HTOWERok/psu_cooler_ficsit/docs/REWORK_v2.md

# Разбор первой печати → план на v2

> **Статус: реализовано в v1.2**, см. `docs/CHANGELOG.md`. Ниже — исходный разбор;
> итоговые массы и время — в changelog и `print/build_report.json`.

Дата: 05.11.2026. Основание: 11 фото из `First_print/`, напечатаны `01_base` и одна `03_wall_rear`.
Снимок исходников на момент разбора: `docs/snapshot_v1.1/`.

---

## 1. Что подтвердилось и уже исправлено (бесплатно, без переделки модели)

**Надпись FICSIT зеркальная — моя ошибка.** В экспорте под печать цоколь и крышка
переворачивались через `mirror([0,0,1])`, а это *отражение*, а не поворот: деталь
получалась зеркальной копией проекта. Винт «причала» при этом остаётся на своём
месте (он симметричен по X), поэтому башня собирается — но логотип читается
наоборот.

Исправлено: `rotate([180,0,0])` вместо `mirror`. Пересобраны `01_base.stl`,
`04_roof.stl` и проекты. Геометрия не менялась — только ориентация в файле.

> **Как правильно переворачивать напечатанную деталь:** вокруг длинной оси (X),
> как она лежала в слайсере. Тогда логотип встаёт на место. Если перевернуть
> вокруг короткой оси — получится зеркало по X, и надпись снова будет наоборот.

---

## 2. Пункты и что с ними делать

| № | Замечание | Причина (моя/процесса) | Решение | Перепечатка |
|---|---|---|---|---|
| 1 | Просадка после «ступеней», похоже на эхо / малый PA | Не модель: на смене направления поток не успевает, + узкие ступени на лицевой грани | PA 0.03 → 0.045; `outer_wall_acceleration` 5000 → 3000; фаски на кромках полос | нет, профиль |
| 2 | Провода кулеров некуда вывести: резал стенку, фрезеровал 2 пропила | Каналы были только по центру кармана (x = ±44), а провод выходит из угла рамки кулера | Кольцевой жёлоб 10 × 4 мм вокруг каждого кармана (скрыт под лотком), соединён с существующими каналами | `01_base` (по желанию) |
| 3, 4, 6 | Ложбинки под провод | — | Нужны размеры (или сделаю по фото) | `01_base` |
| 5 | Логотип не туда | см. п.1 | исправлено | `01_base`, `04_roof` |
| 7а | Недолив первого слоя при потоке 1.2 | Ширина линии 0.65 при сопле 0.6 — линиям некуда раздаться, поток уже на пределе | `initial_layer_line_width` 0.65 → 0.75; слой первого слоя 0.4 → 0.35 | нет, профиль |
| 7б | Два прямоугольника на причале ни о чём | Я делал их пазами под стяжку, но 2 мм глубины ничего не держат, а провод идёт снизу | Убрать; вместо них два сквозных паза 18 × 4 мм под стяжку | `01_base` |
| 8 | Переэкструзия верхнего слоя стенки | Перемычки между сотами 3.3 мм при линии 0.62: остаток 0.2 мм забивается «щелевым» доливом | Перемычка 3.3 → 3.1 мм (=5 × 0.62); `top_surface_flow` 0.95 | `02/03_wall` |
| 9 | «Уши» задирает, комки, отверстия не печатаются | Ухо — башня 28 мм высотой и 4 мм толщиной; отверстие M3 идёт горизонтально и провисает | Полка 4 → 6 мм; скругления R2 и фаска на торце; отверстие «каплей» (teardrop) | `02/03_wall` |

---

## 3. Что именно меняю в модели (v2)

### `02/03_wall`
1. **Полка уха 4 → 6 мм** (z 34…40 вместо 36…40). Кирпичный паз 38…40 не трогаю.
2. **Скругления R2** на внешних углах уха и **фаска 1.5 × 45°** на торце — снимает комки на углах.
3. **Отверстия «каплей»**: Ø3.6 (крепление к цоколю) и Ø4.4 (крышка) получают
   45-градусный свод сверху по направлению печати — горизонтальное отверстие
   перестаёт провисать.
4. **Перемычка сот 3.3 → 3.1 мм**.

### `01_base` (только если печатать заново)
1. Ориентация (п.1) — уже исправлено.
2. **Жёлоб под провода**: кольцо 10 × 4 мм вокруг каждого кармана на нижней плоскости,
   соединённое с каналами x = ±44. Провод выходит из любого угла кулера.
3. **Пазы причала**: два сквозных 18 × 4 мм вместо двух неглубоких прямоугольников.

### `04_roof`
Ориентация исправлена, больше ничего.

### Профили (`DSH_JAMG-HE ABS` / `DSH ABS 0.6 0.2mm`)
- `initial_layer_line_width` 0.75, `initial_layer_print_height` 0.35;
- `pressure_advance` 0.045;
- `outer_wall_acceleration` 3000;
- `top_surface_flow` 0.95.

---

## 4. Что нужно от тебя

1. **Размеры ложбинок** (пункты 3, 4, 6): длина × ширина × глубина и на каком
   расстоянии от края — или «сделай как на фото», тогда возьму 25 × 4 × 4 мм.
2. **Пункт 1**: на каком именно месте просадка — на лицевой грани (полосы/логотип)
   или на полке причала? От этого зависит, править модель или только профиль.
3. **Печатать ли цоколь заново.** Если да — 4 ч 10 м и ~131 г, зато логотип,
   жёлоб и пазы. Если нет — оставляем напечатанный, а правки уходят в v2 для будущих.
