HTOWERok/psu_cooler_ficsit/photos/05_front_with_roof.jpg

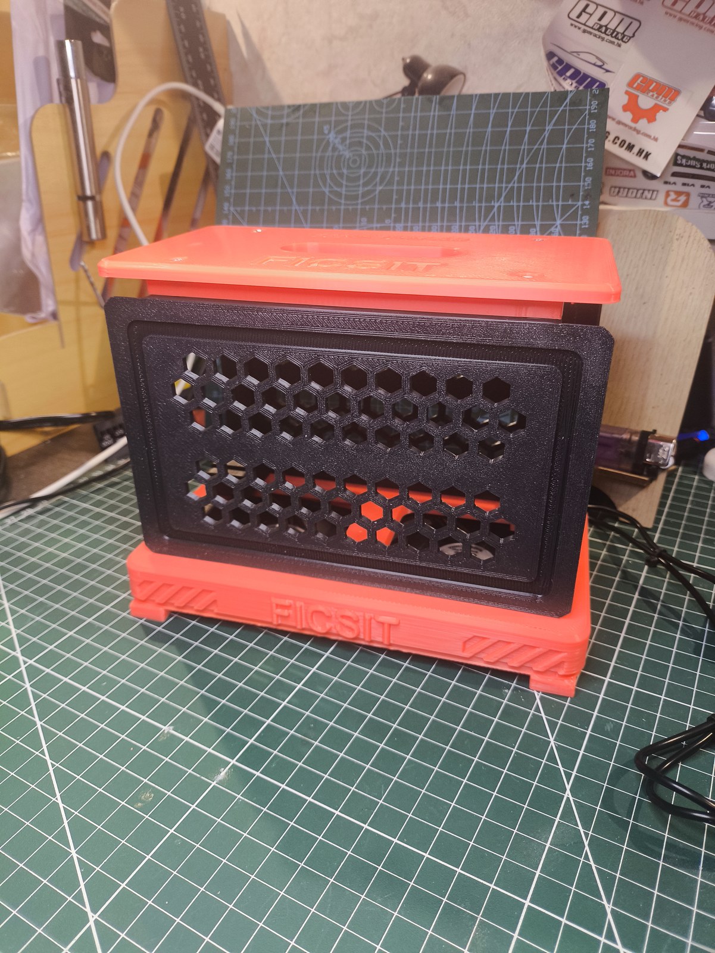
photos/05_front_with_roof.jpg
