HTOWERok/psu_cooler_ficsit/photos/06_base_underside.jpg

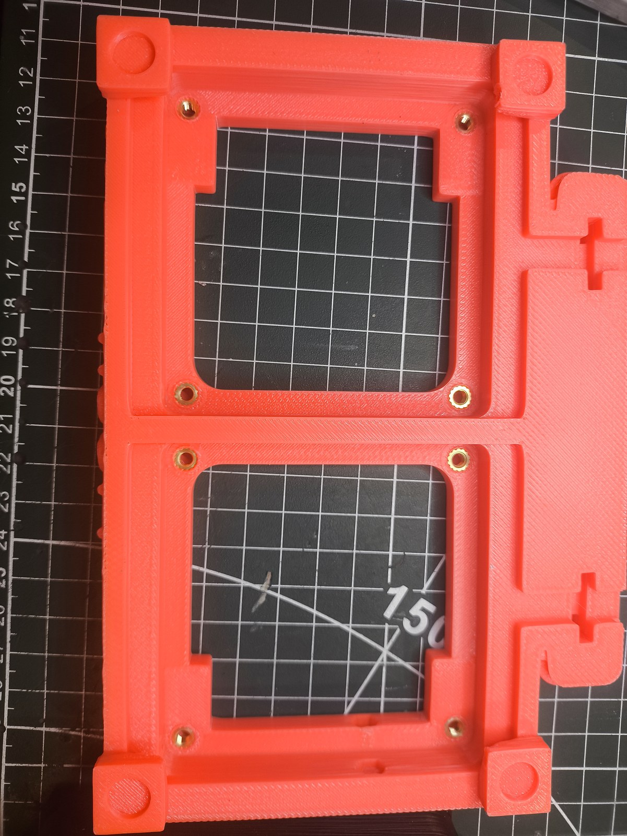
photos/06_base_underside.jpg
