HTOWERok/psu_cooler_ficsit/photos/07_heat_inserts.jpg

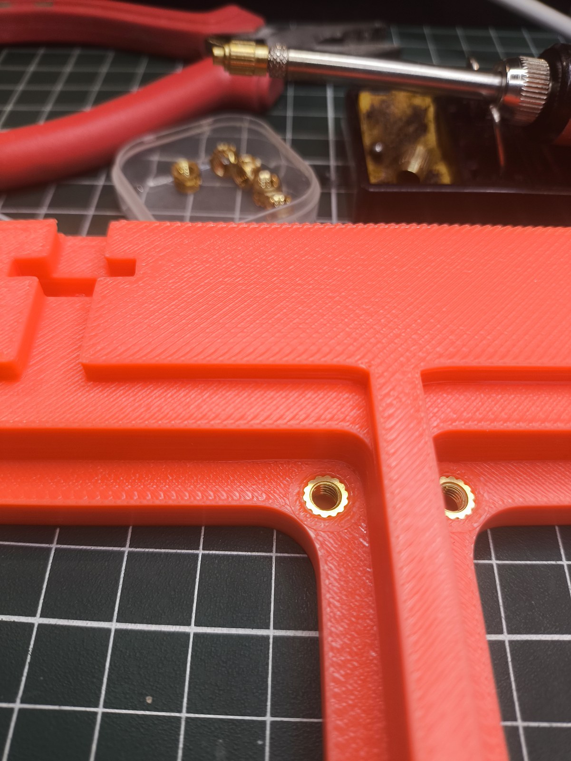
photos/07_heat_inserts.jpg
