HTOWERok/psu_cooler_ficsit/renders/02_open.png

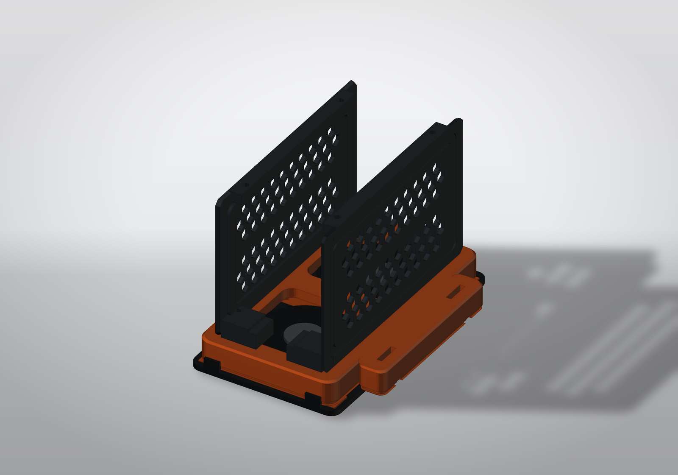
renders/02_open.png
