HTOWERok/psu_cooler_ficsit/renders/04_front.png

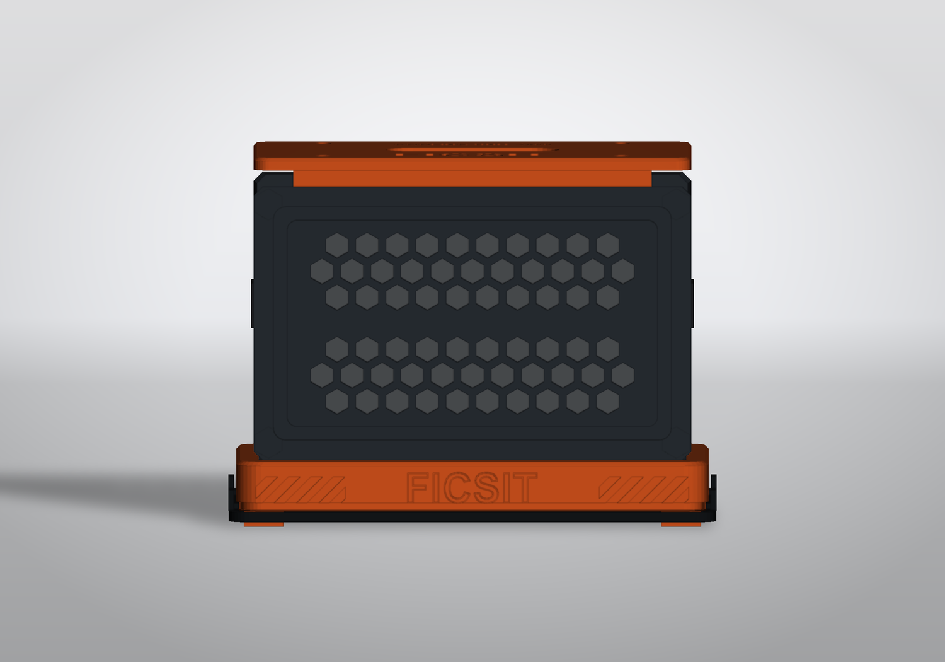
renders/04_front.png
