HTOWERok/psu_cooler_ficsit/renders/05_detail.png

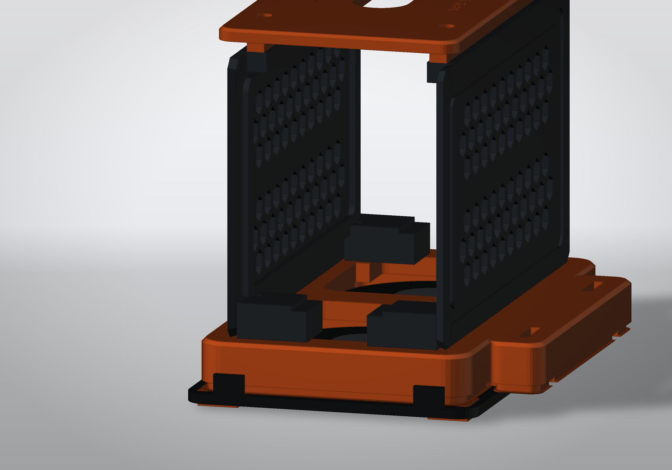
renders/05_detail.png
