HTOWERok/psu_cooler_ficsit/renders/06_top.png

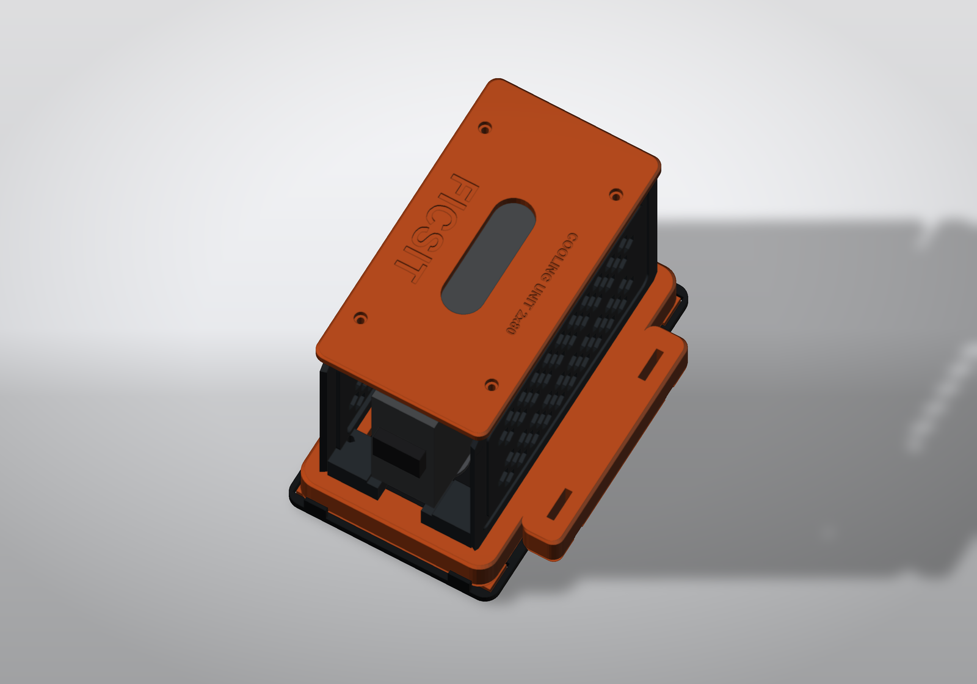
renders/06_top.png
