HTOWERok/psu_cooler_ficsit/renders/section_01_base_z8.png

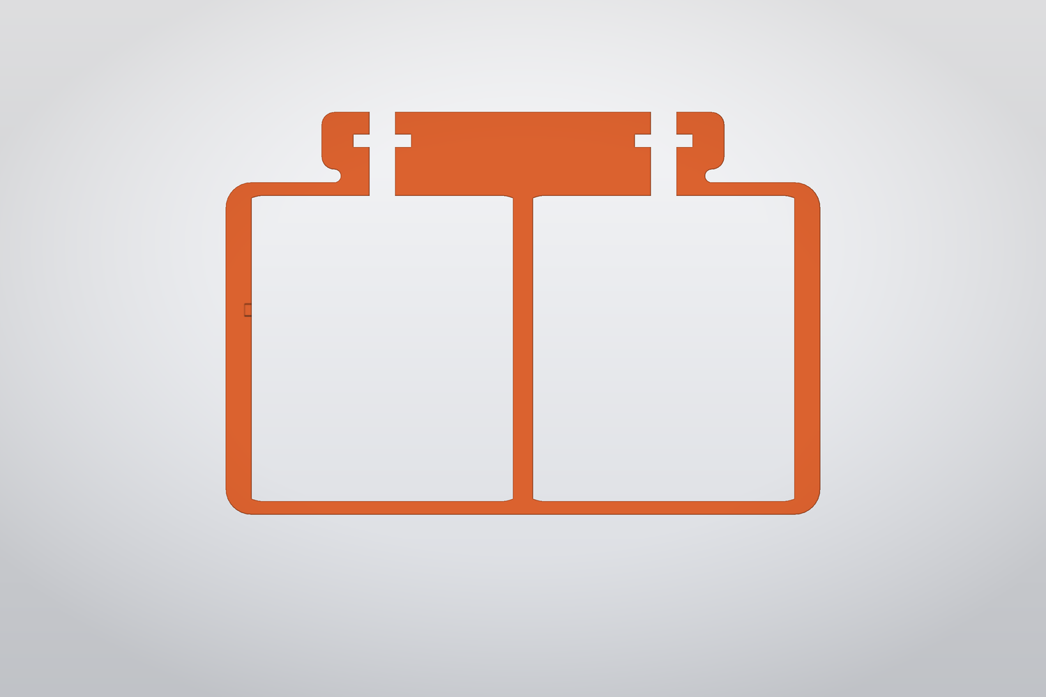
renders/section_01_base_z8.png
