HTOWERok/psu_cooler_ficsit/renders/section_01_base_z22.png

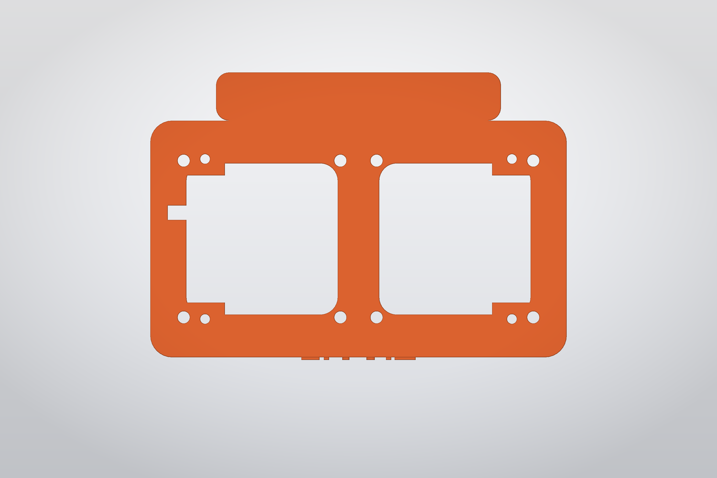
renders/section_01_base_z22.png
