HTOWERok/psu_cooler_ficsit/print/projects/03_wall_rear.3mf

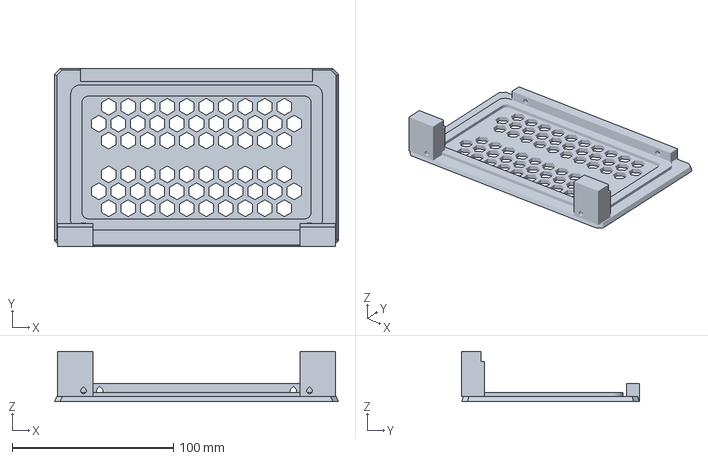
[picture p18: CAD file, 2026-11-09]
print/projects/03_wall_rear.3mf
176.0 x 110.0 x 31.2 mm
