HTOWERok/psu_cooler_ficsit/print/projects/01_base.3mf

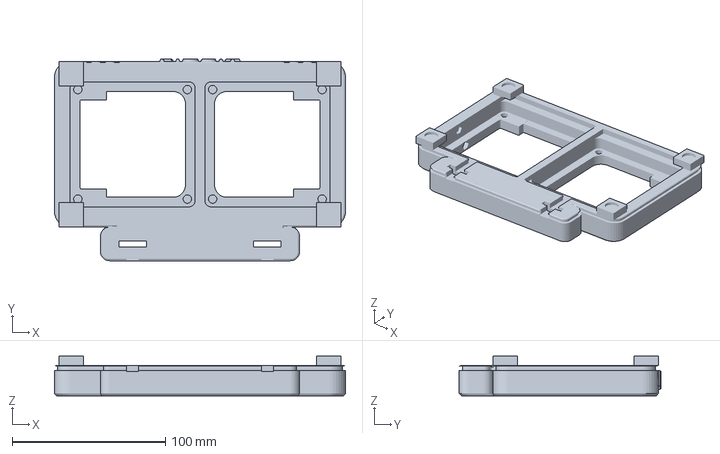
[picture p19: CAD file, 2026-11-09]
print/projects/01_base.3mf
190.0 x 131.6 x 26.0 mm
