HTOWERok/psu_cooler_ficsit/print/projects/05_filter_tray.3mf

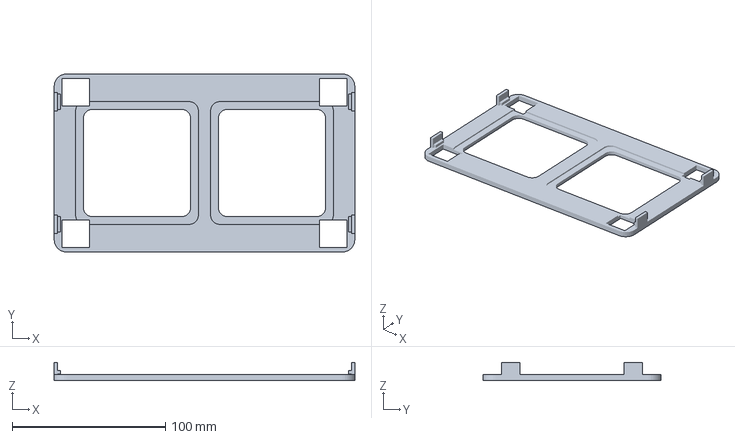
[picture p20: CAD file, 2026-11-09]
print/projects/05_filter_tray.3mf
196.2 x 116.0 x 12.0 mm
