HTOWERok/psu_cooler_ficsit/stl/04_roof.stl

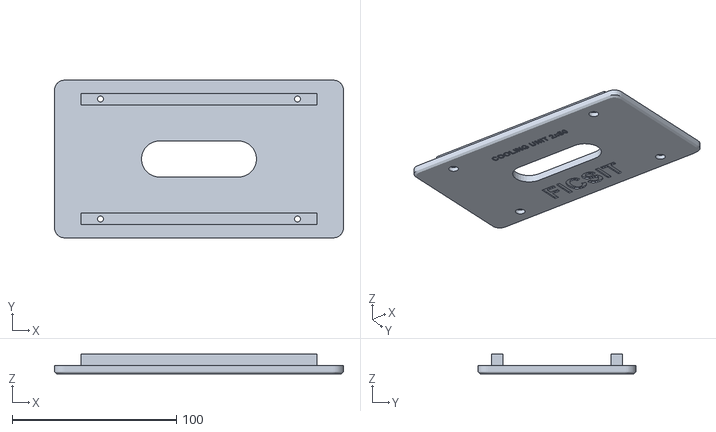
[picture p21: CAD file, 2026-11-09]
stl/04_roof.stl
176.0 x 96.0 x 12.0
