HTOWERok/psu_cooler_ficsit/(list of files, cad)

Other CAD files:
stl/03_wall_rear.stl
stl/02_wall_front.stl
print/projects/04_roof.3mf
stl/01_base.stl
print/projects/02_wall_front.3mf
stl/05_filter_tray.stl
