HTOWERok/psu_cooler_ficsit/print/README.md

# Печать: ABS, сопло 0,6, OrcaSlicer

Всё подготовлено, **печать не запущена**, Z-offset и настройки принтера не тронуты.

- **Профили:** `JAMG-HE ABS` → копия **`DSH_JAMG-HE ABS`** (установлена в орку), процесс → **`DSH ABS 0.6 0.2mm`** (установлен).
- **Проекты:** 5 файлов в `projects/` — открыть двойным щелчком, каждый уже с расставленной деталью, бримом и профилями.
- **Проверено слайсером:** все пять режутся без ошибок, поддержек — **0 грамм**.

---

## 1. Что печатаем и сколько это стоит

| № | Деталь | Слой | Слоёв | Пластик | Время | Поддержки |
|---|---|---|---|---|---|---|
| 1 | `05_filter_tray` | 0,2 | 59 | **37,9 г** | 1 ч 04 м | 0 |
| 2 | `04_roof` | 0,2 | 59 | **61,7 г** | 1 ч 48 м | 0 |
| 3 | `02_wall_front` | 0,2 | 155 | **65,1 г** | 2 ч 23 м | 0 |
| 4 | `03_wall_rear` | 0,2 | 155 | **64,7 г** | 2 ч 22 м | 0 |
| 5 | `01_base` | 0,2 | 129 | **129,6 г** | 4 ч 12 м | 0 |
| | **Итого** | | | **≈ 359 г** | **≈ 11 ч 30 м** | **0** |

Проверьте, что в катушке больше 400 г — на брим, продувку и возможный перезапуск.

> **v1.1 (исправление):** в цоколе отверстие M3 под стойку стенки стояло в 3,26 мм от отверстия M4 под кулер — при радиусах 2,2 + 2,75 они прорезали друг друга, и бонку некуда было вплавить. Стойки M3 перенесены с x = ±77 на x = ±70 (y = 36,5), а в «полке» деки сделаны местные утолщения, чтобы под них появилось мясо. Заодно исправлено отверстие M3 в самой стенке: раньше оно не проходило сквозь полку кронштейна. Пересобраны `stl/01_base.stl`, `stl/02_wall_front.stl`, `stl/03_wall_rear.stl` и три проекта; фильтр-лоток и крышка не менялись.

---

## 2. Порядок печати

1. **`05_filter_tray`** — самый быстрый и самый «показательный»: на нём видно, легла ли линия, держится ли брим, нет ли отрыва углов. Если что-то не так — вы теряете час, а не четыре.
2. **`04_roof`** — вторая проверка, уже с гравировкой на первом слое.
3. **`02_wall_front`**, затем **`03_wall_rear`** — они одинаковые по времени; между ними дайте столу остыть и проверьте, не повело ли первую.
4. **`01_base`** — самая большая и самая капризная по короблению. Печатать последней, когда профиль уже подтверждён.

---

## 3. Что в профиле было не так и что я изменил

Профиль **`JAMG-HE ABS`** рабочий, но собран на скелете PLA: `inherits: Flashforge Generic PLA`, и в нём несколько мест, которые для ABS либо инертны, либо вредны.

### Копия `DSH_JAMG-HE ABS` — отличия от оригинала (4 правки)

| Параметр | Было | Стало | Почему |
|---|---|---|---|
| `during_print_exhaust_fan_speed` | 70 % | **0 %** | Вытяжка во время печати выдувает тёплый воздух из камеры → перепад → отрыв углов. После печати остаётся 70 % (`complete_print_exhaust_fan_speed`), чтобы вытянуть запах. |
| `overhang_fan_speed` | 30 % | **20 %** | Было больше `fan_max_speed` (20 %) — на нависаниях обдув бил сильнее, чем разрешено для ABS. Теперь не превышает потолок. |
| `slow_down_layer_time` | 150 с | **15 с** | При `slow_down_for_layer_cooling = 0` параметр не работает, но если когда-нибудь включить охлаждение — 150 с на слой превратят печать в бесконечность. Приведено к безопасному значению. |
| компенсация усадки | нет | **нет** | Специально не добавлял: зазоры в модели (0,3–1,4 мм) уже перекрывают усадку ABS 0,4–0,6 %. Плюс в CLI-слайсе параметр не применяется, и я не хочу, чтобы «проверено» и «напечатано» расходились. |

Температуры, обдув, ретракт, MVS — **не тронуты**: 255/260 °C, стол 90/100 °C, обдув 10–20 %, MVS 20 мм³/с. Всё в пределах заявленного диапазона сопла 240–280 °C.

### Правки v1.2 (по итогам первой печати)

| Параметр | Было | Стало | Почему |
|---|---|---|---|
| `initial_layer_line_width` | 0,65 | **0,72** | На первом слое просветы между линиями: при сопле 0,6 и потоке 1,2 линии ширины не хватало |
| `initial_layer_print_height` | 0,40 | **0,35** | Больше прижима, не трогая Z-offset |
| `top_surface_flow` | 1,0 | **0,95** | Верхняя поверхность стенки была перелита (узкие перемычки между сотами) |
| `pressure_advance` | 0,03 | **0,045** | Просадка после ступеней на лицевой грани |
| `outer_wall_acceleration` | 5000 | **3000** | Там же: меньше «эха» на смене направления |

### Выходной G-код — включены все четыре опции

| В UI | Ключ | Что даёт |
|---|---|---|
| Откат только при пересечении периметров | `reduce_infill_retraction` = 1 | нет ретракта внутри заполнения |
| Подробный G-код | `gcode_comments` = 1 | к каждой строке — комментарий с типом элемента |
| Помечать модели | `gcode_label_objects` = 1 | `;EXCLUDE_OBJECT_DEFINE/START/END` вокруг детали |
| Исключение объектов | `exclude_object` = 1 | принтер может пропустить объект, не останавливая печать |

Отдельного ключа `verbose_gcode` в Orca 2.3.2 нет (проверено по `OrcaSlicer.dll`) — за «Подробный G-код» отвечает `gcode_comments`.

Файлы от этого выросли: цоколь **33,4 МБ**, стенка **13,3 МБ**, крышка **11,0 МБ**, лоток **4,7 МБ** (до правки было в 3–4 раза меньше). На время печати это не влияет, но загрузка по Wi-Fi и разбор файла принтером станут заметно дольше.

### Что осталось как есть (но знать полезно)

- **`inherits: Flashforge Generic PLA`** — работает, но хрупко: тянет из PLA `filament_flow_ratio 0.98` и прочие мелочи. Копию я оставил на том же родителе, чтобы поведение было предсказуемым. Если захотите «чистый» профиль — перевесить родителя на `Flashforge Generic ABS` и заново проверить поток.
- **`slow_down_layer_time = 150`** в оригинале — см. выше, исправлено в копии.
- **`filament_max_volumetric_speed = 20`** — для ABS на 0,6 это на грани, но скорости процесса (внешняя стенка 150, заполнение 100–150) держат расход ниже. Не менял.
- **`flexible? нет`**, `filament_density 1.04` ✓ — масса в отчёте считается верно.

### Процесс `DSH ABS 0.6 0.2mm` — отличия от вашего `Jamg-HE - ABS 0,18`

| Параметр | Было | Стало | Почему |
|---|---|---|---|
| Поддержки | вкл, tree(auto), 55° | **выкл** | См. раздел 4 — детали спроектированы без нависаний >45°, поддержки дают 0 г. |
| Брим | auto | **outer_only, 8 мм** | ABS + большая плоская деталь: брим по внешнему контуру держит углы, внутрь окон не лезет. |
| Слоновья нога | 0 | **0,15 мм** | Первый слой 0,4 мм на PEI-столе иначе раздаётся на 0,2–0,3 мм, и посадочные места теряют точность. |
| Тип стола | Cool Plate (35 °C!) | **Textured PEI** (100 → 90 °C) | При экспорте проект по умолчанию брал «холодный стол» — ABS бы просто не прилип. |

Остальное — ваши значения: 0,2 мм слой, 0,4 первый, 3 периметра, 30 % gyroid, 4 верхних слоя, arachne, шов сзади.

---

## 4. Поддержки: почему 0 г

Проверял не «на глаз», а слайсером:

- с вашим включённым `tree(auto) 55°` → `;TYPE:Support` в gcode **нет**, масса та же 38,84 г;
- принудительно `support_threshold_angle = 20°` → **тоже 0**.

Причина: все детали печатаются в ориентации, где нависания — только фаски 45° и кромки сот, а порог стоит 55°. Дерево в ABS ещё и приваривается к модели, оставляя следы на видимых гранях. Поэтому поддержки выключены — это не «забыл», это осознанно.

Если всё же захотите: в проекте `Support → Enable` и порог 40–45°, но тогда на кромках сот появятся следы.

---

## 5. Перед стартом — проверьте

- [ ] **Катушка:** ≥ 400 г чёрного ABS.
- [ ] **Стол:** текстурированная PEI-пластина, обезжирена. В проекте стоит `Textured PEI Plate`, 100 °C первый слой → 90 °C дальше.
- [ ] **Сопло 0,6** — в проекте `nozzle_diameter 0.6`, ширина линии 0,62.
- [ ] **Z-offset не трогаем** (как просили). Если первый слой примнёт — правьте только `flow` первого слоя или высоту слоя, не офсет.
- [ ] **Камера:** для 190-мм детали желательно закрыть корпус/поставить щит — сквозняк отрывает углы быстрее, чем что-либо ещё. В орке: `Others → Draft shield` (увеличит время примерно на 20–25 %).
- [ ] **Первый слой** смотрите на `05_filter_tray`: брим 8 мм по контуру должен быть сплошным, без «перьев».

Если углы всё же поднимаются: поднять стол до 100 °C (это всё ещё норма для ABS) и уменьшить обдув до 0 на первых 5–6 слоях (сейчас `close_fan_the_first_x_layers = 3`).

---

## 6. Физический принтер в проектах

Во всех пяти `.3mf` записан принтер `Flashforge Adventurer 5M 0.6 Nozzle - DSH`:

| Поле в Orca | Ключ | Значение |
|---|---|---|
| Сохранить принтер как | `printer_settings_id` | Flashforge Adventurer 5M 0.6 Nozzle - DSH |
| Тип хоста | `host_type` | `flashforge` |
| Имя хоста, IP | `print_host` | `192.168.31.30` |

Сетевой агент (`printer_agent`), сертификат и проверки отзыва Orca в проект не пишет — они остаются дефолтными, и в диалоге это как раз «Orca», пусто и галочка снята. Проверено пробным экспортом: Orca при выбранном DSH-принтере кладёт в 3mf ровно три поля выше.

Значения заданы в `build_projects.py` (словарь `HOST`), так что при пересборке проектов они не потеряются.

Что важно знать:

- процесс `DSH ABS 0.6 0.2mm` объявлен совместимым **с обоими** принтерами (`… Nozzle` и `… - DSH`). Без второго имени Orca при открытии проекта считала процесс несовместимым и откатывала выбор принтера на базовый;
- сам **принтер** — это пользовательский пресет в профиле Orca, а не часть 3mf. Один раз сохраните его с тем же именем (`… - DSH`) — и все пять проектов подхватят его автоматически;
- на другом компьютере/профиле проекта этого пресета не будет, и Orca откроет проект с базовым принтером. Лечится тем же сохранением под тем же именем;
- слайсер в пайплайне режет с **базовым** именем (`Flashforge Adventurer 5M 0.6 Nozzle`) — CLI не умеет работать с пользовательскими пресетами. Поэтому в `build_report.json` цифры сняты с базового пресета, а в готовый проект записано имя с хостом.

---

## 7. Что где лежит

```
print/
├─ projects/                 ← 5 готовых проектов орки (открывать их)
│  ├─ 01_base.3mf            190 × 131,6, «вверх дном», 129 слоёв
│  ├─ 02_wall_front.3mf      наружной гранью вниз
│  ├─ 03_wall_rear.3mf       зеркальная
│  ├─ 04_roof.3mf            верхней плоскостью вниз
│  └─ 05_filter_tray.3mf     плоско, клипсами вверх
├─ presets/                  ← те же профили для «Load preset from file»
├─ gcode_check/plate_1.gcode ← контрольный слайс фильтр-лотка (можно открыть в орке)
├─ build_report.json         ← цифры из слайсера (слои, масса, время, размер gcode)
├─ filament_flat.json        ← ровно тот конфиг, что ушёл в проекты
├─ process_flat.json
├─ machine_flat.json
├─ flatten.py                ← разворачивает цепочку наследования в один файл
├─ build_projects.py         ← экспорт + патч + слайс
├─ test_variants.py          ← A/B: поддержки, усадка
└─ install_presets.py        ← установка профилей в орку
```

### Про имена профилей

Файлы в орке: `filament\DSH_JAMG-HE ABS.json` и `process\DSH ABS 0.6 0.2mm.json`
(плюс `.info`). **Орка была открыта** во время установки — если профили не появились в списке, перезапустите её. Даже без профилей проекты самодостаточны: все настройки лежат внутри `.3mf`.

### Почему проектов пять, а не один

Детали не помещаются на стол попарно: 190 + 8-мм брим = 206 мм по X, а стенка с бримом — 192 × 126 мм. Два объекта на 220 × 220 уже не влезают с зазором. Плюс для ABS лучше печатать по одной детали: нет соседних потоков воздуха и остывающих «соседей».

### Как это воспроизвести

```powershell
$py = "C:\Users\Craftroom\.dsh\dsh-runtimes\dsh-primary-runtime\dependencies\python\python.exe"
cd print
& $py flatten.py "Flashforge Adventurer 5M 0.6 Nozzle" machine_flat.json ov_machine.json
& $py flatten.py "Jamg-HE - ABS 0,18" process_flat.json ov_process.json
& $py flatten.py "JAMG-HE ABS" filament_flat.json ov_filament.json
& $py build_projects.py --slice
& $py install_presets.py
```

CLI орки не умеет: принимать пресеты с не-ASCII именем и подхватывать цепочку наследования у профиля принтера. Поэтому `flatten.py` разворачивает всё в плоский JSON, а `build_projects.py` домешивает настройки принтера в проект уже после экспорта. Обходные места помечены комментариями в коде.
