HTOWERok/psu_cooler_ficsit/First_print/2.jpg

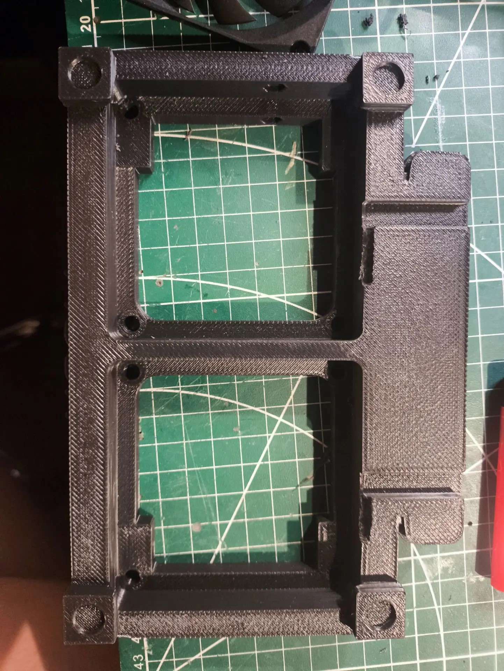
First_print/2.jpg
