HTOWERok/psu_cooler_ficsit/First_print/3.jpg

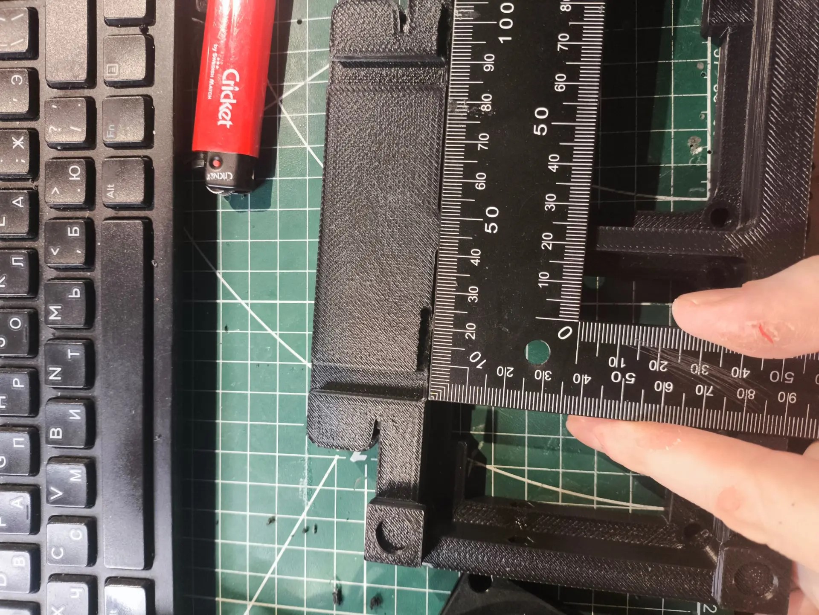
First_print/3.jpg
