HTOWERok/psu_cooler_ficsit/First_print/4.jpg

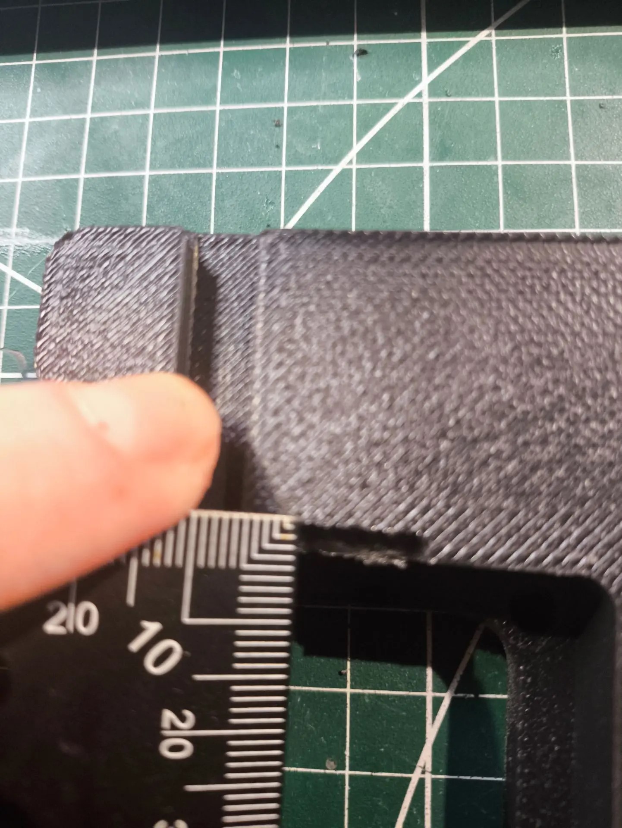
First_print/4.jpg
