HTOWERok/psu_cooler_ficsit/First_print/5.jpg

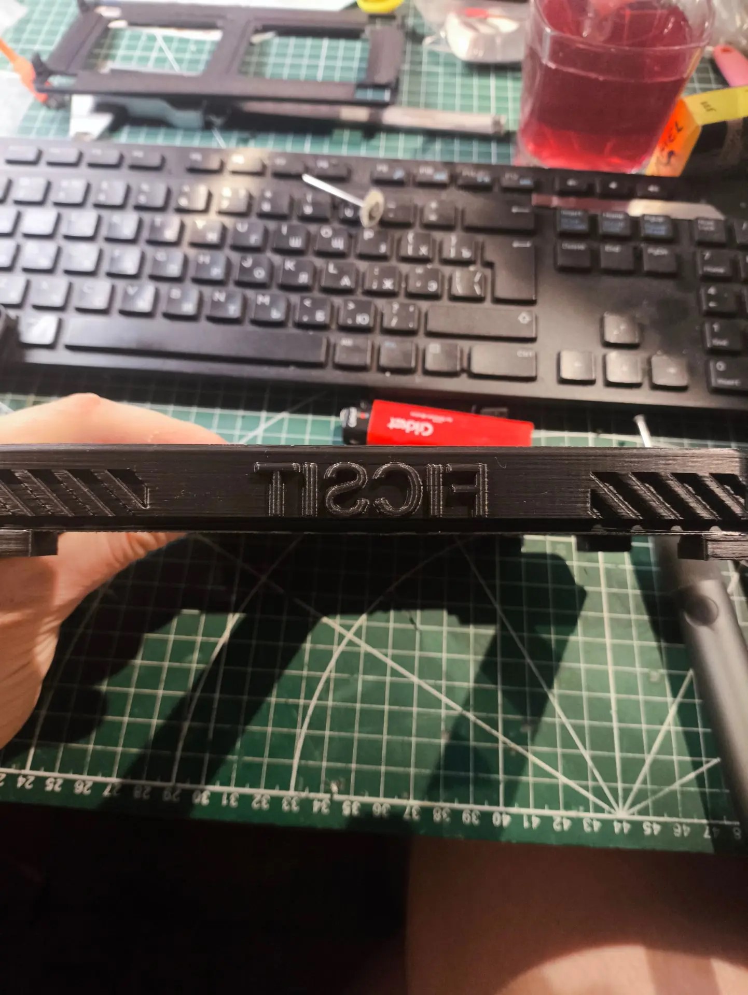
First_print/5.jpg
