HTOWERok/psu_cooler_ficsit/First_print/6.jpg

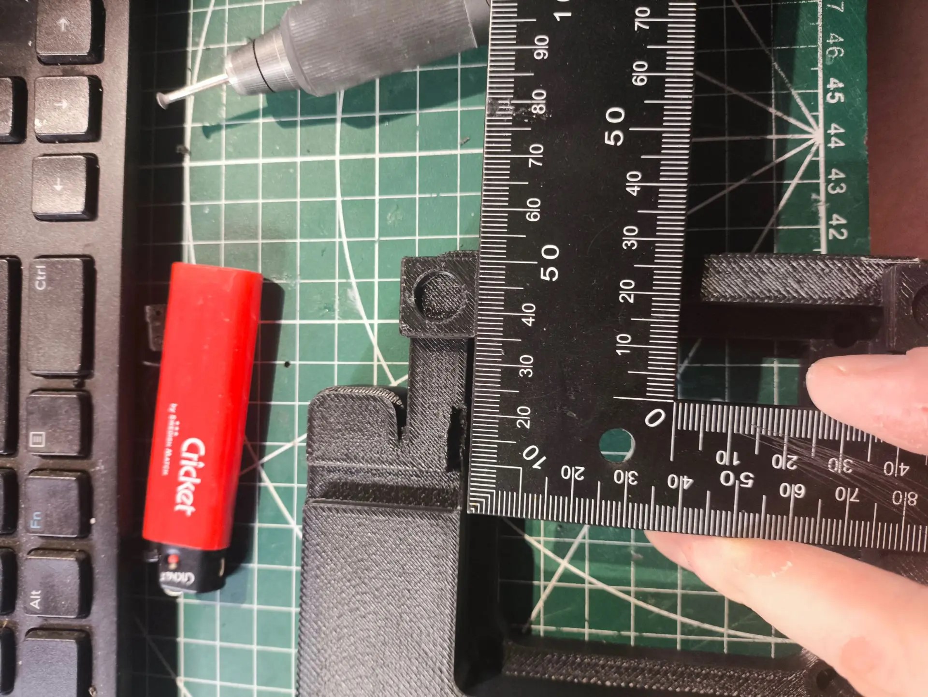
First_print/6.jpg
