HTOWERok/psu_cooler_ficsit/First_print/7.jpg

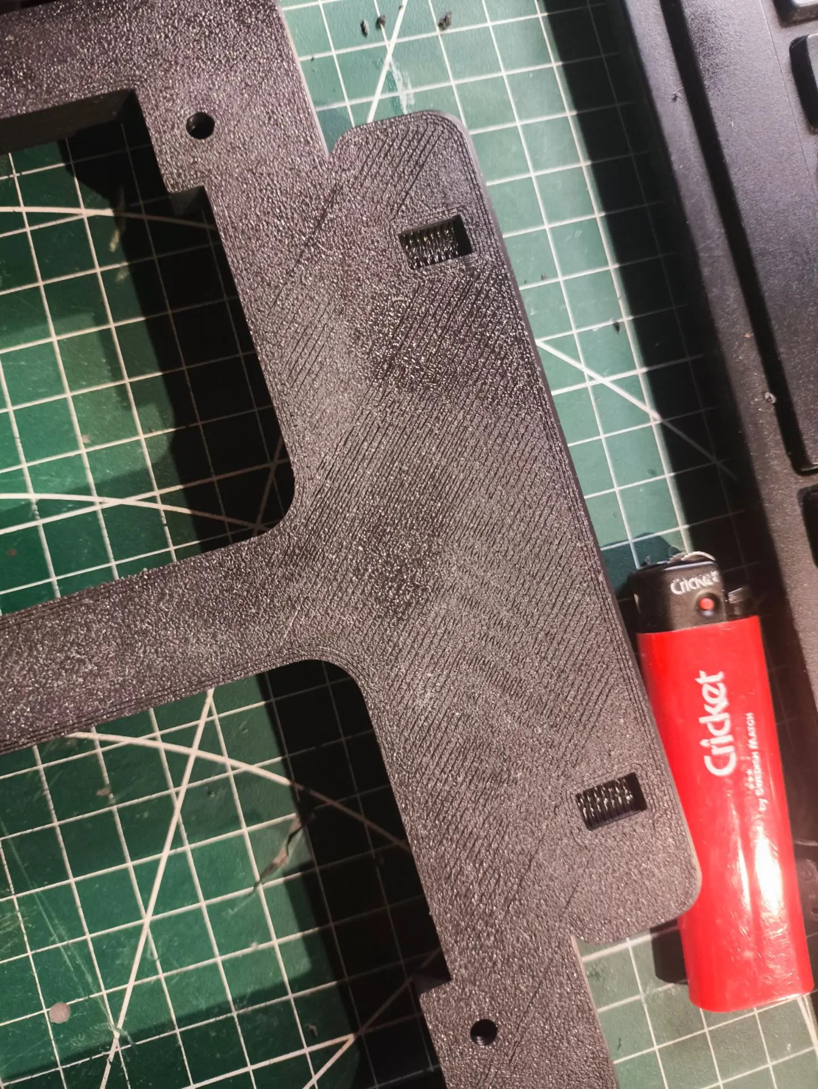
First_print/7.jpg
