HTOWERok/psu_cooler_ficsit/First_print/8.jpg

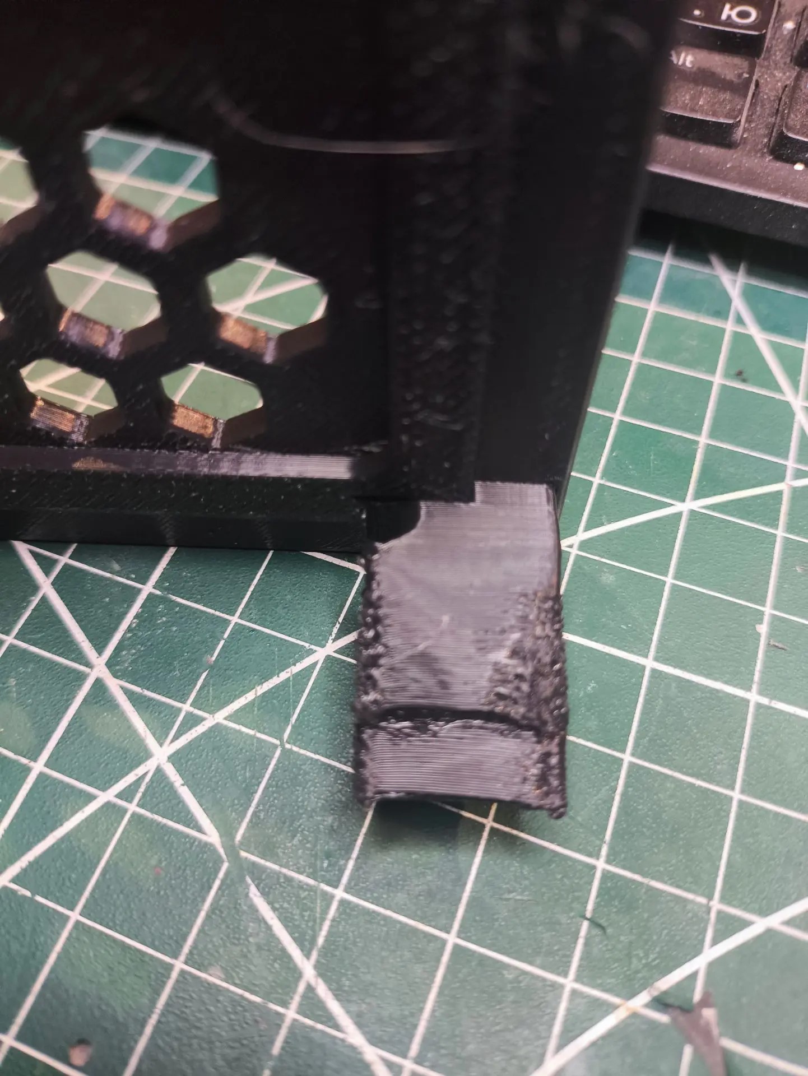
First_print/8.jpg
