HTOWERok/psu_cooler_ficsit/First_print/9.jpg

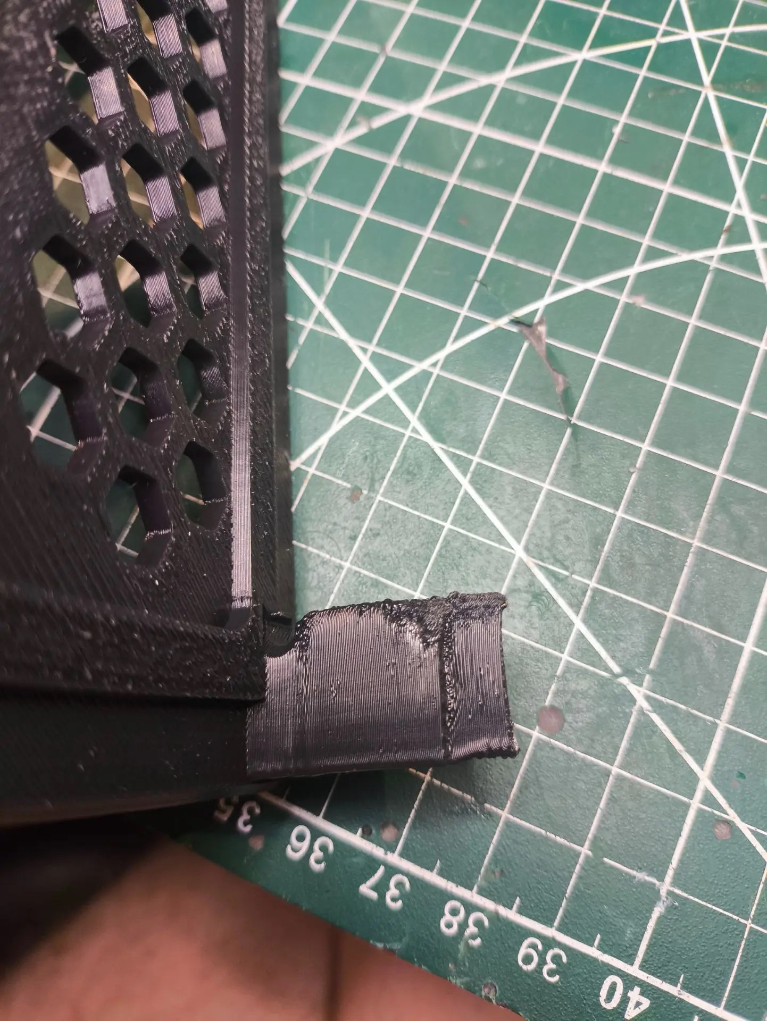
First_print/9.jpg
