HTOWERok/psu_cooler_ficsit/First_print/10.jpg

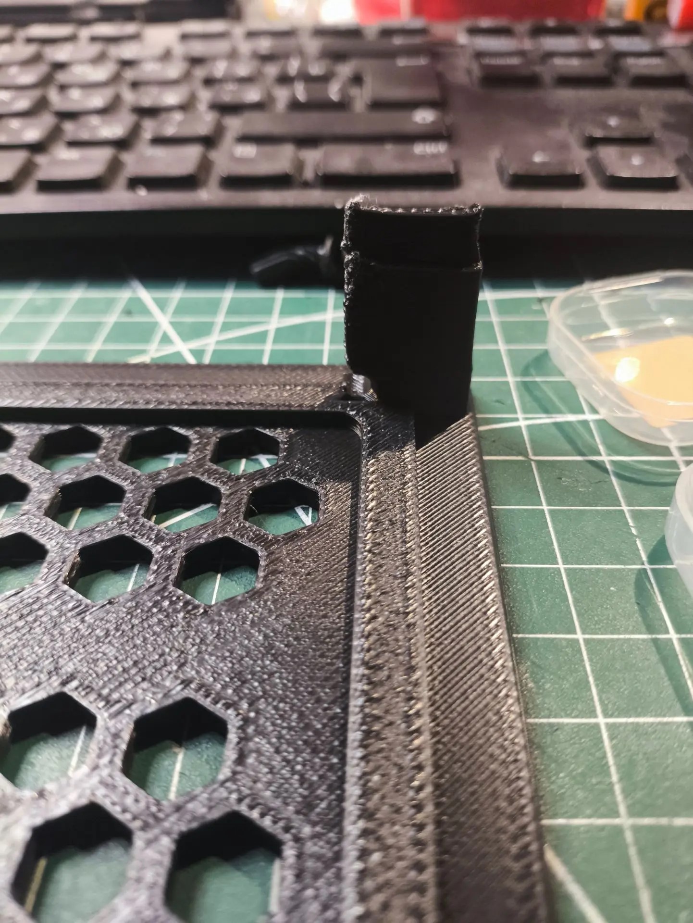
First_print/10.jpg
