HTOWERok/psu_cooler_ficsit/docs/CHANGELOG.md

# История версий

## v1.2 — 2026-11-07 (по итогам первой печати)

Разбор фото: `First_print/1.jpg … 11.jpg`. План и обоснование: `docs/REWORK_v2.md`.

| № | Замечание | Что сделано |
|---|---|---|
| 5 | Логотип печатался зеркально | Экспорт переворачивал деталь через `mirror([0,0,1])` — это отражение. Заменено на `rotate([180,0,0])` для цоколя и крышки. Переворачивать напечатанное — вокруг длинной оси. |
| 2 | Провода кулеров некуда вывести | Жёлоб 7 × 4 мм по передней и задней стороне каждого кармана (скрыт под лотком), соединён с каналами x = ±44. Ограничен по X, чтобы не подрезать 5,6-мм перегородку между кулерами. |
| 7б | Два неглубоких прямоугольника на причале | Убраны; вместо них два сквозных паза 18 × 4 мм под стяжку. |
| 9 | «Уши» задирало, комки, отверстия не печатались | Ухо стало **сплошным башмаком** от деки (z = 26) до полки (z = 40), 22 × 28 мм в плане: в печати — солидный блок вместо 4-мм полки на 28-мм ножке. Отверстия M3 и M4 — «каплей» (teardrop 45°), чтобы горизонтальный свод не провисал. Верхняя планка расширена до 8 мм: вокруг отверстия M3 остаётся ≥ 2,3 мм (3–4 прохода сопла). |
| 8 | Переэкструзия верхнего слоя стенки | Перемычка между сотами 3,3 → 3,1 мм = ровно 5 проходов по 0,62; `top_surface_flow` 0,95. |
| 7а | Недолив первого слоя | `initial_layer_line_width` 0,65 → 0,72; `initial_layer_print_height` 0,4 → 0,35. |
| 1 | Просадка после ступеней на лицевой грани | PA 0,03 → 0,045; `outer_wall_acceleration` 5000 → 3000. |

Массы и время v1.2:

| Деталь | v1.1 | v1.2 |
|---|---|---|
| `01_base` | 130,8 г / 4 ч 10 м | 129,6 г / 4 ч 12 м |
| `02_wall_front` | 58,8 г / 2 ч 10 м | 65,1 г / 2 ч 23 м |
| `03_wall_rear` | 58,7 г / 2 ч 10 м | 64,7 г / 2 ч 22 м |
| `04_roof` | 62,6 г / 1 ч 48 м | 61,7 г / 1 ч 48 м |
| `05_filter_tray` | 38,8 г / 1 ч 05 м | 37,9 г / 1 ч 04 м |

Профили `DSH ABS 0.6 0.2mm` и `DSH_JAMG-HE ABS` изменены на месте (прежние значения
не сохраняются) и переустановлены в Orca — **перезапустить Orca**, чтобы увидеть.

### Кулеры 80 × 80 × 11 мм (замерено)

Карман 82,4 × 82,4 × **12,6** мм, низ кармана на z = 6, потолок на 18,6. Кулер 11 мм
встаёт с зазором **1,6 мм** над лопастями — геометрию менять не пришлось (влезает
любой от 10 до 12 мм). Винт идёт снизу: 12,5 мм до гнезда + 6 мм резьбы, поэтому
**M4 × 18** (× 16 тоже держит — 3,5 мм резьбы), а × 20 упирается в дно гнезда
за 0,8 мм до посадки головки.

### Выходной G-код

Включены все четыре опции: `reduce_infill_retraction`, `gcode_comments` (в UI
«Подробный G-код»; ключа `verbose_gcode` в Orca 2.3.2 нет — проверено по
`OrcaSlicer.dll`), `gcode_label_objects`, `exclude_object`.

Из-за комментариев файлы выросли: цоколь 33,4 МБ, стенки 13,3 / 13,2 МБ,
крышка 11,0 МБ, лоток 4,7 МБ. Время и масса не изменились.
Размер пишется в `print/build_report.json` (`gcode_mb`).

### Физический принтер в проектах

Во все пять `.3mf` записано: `printer_settings_id = "Flashforge Adventurer 5M 0.6 Nozzle - DSH"`,
`host_type = flashforge`, `print_host = 192.168.31.30` (ровно те три поля, которые пишет
сама Orca — проверено пробным экспортом).
Значения — в словаре `HOST` файла `print/build_projects.py`.
В `print_compatible_printers` процесса добавлено имя `… - DSH`, иначе Orca считала
процесс несовместимым с этим принтером и откатывала выбор на базовый.

### Гнёзда M3 под стенки: Ø4,4 → Ø4,0

Замер на напечатанном цоколе: отверстие Ø4,4 в модели вышло **4,0 мм** (усадка отверстия
≈0,4 мм). Бонка M3 (OD 4,0) в таком гнезде не держится. Поставил в модели **Ø4,0** —
на детали ожидается **≈3,6 мм**, то есть натяг 0,4 мм. То же для двух гнёзд M3 в верхней
рейке стенки (под винты крышки). Вставки в спецификации: OD **4,0**, а не 4,5.

## v1.1 — 2026-11-05

**Исправлено:** в цоколе отверстие M3 под стойку стенки (`x = ±77, y = 37,5`) стояло в
**3,26 мм** от отверстия M4 под крепление кулера (`x = ±79,75, y = 35,75`).
При радиусах 2,2 + 2,75 = 4,95 мм они прорезали друг друга: бонка M3 попадала
в полость бонки M4, и вплавить её было некуда.

| Файл | Что изменено |
|---|---|
| `src/model.py` → `01_base` | Стойки M3 перенесены на `x = ±70, y = 36,5`; в «полке» деки добавлены местные утолщения (18 × 11,6 мм), чтобы под стойку появилось мясо — они лежат вне окружности лопастей. Глубина гнезда 6,5 мм вместо 7,2. |
| `src/model.py` → `02/03_wall` | Отверстие M3 раньше шло только `z = 25…30,5` и не доходило до полки кронштейна (z = 36…40) — винт не мог притянуть стенку. Теперь сквозное `z = 25,5…40,5` с зенковкой 90° на верхней плоскости полки. |
| `src/check_holes.py` | Новый автодопуск: режет деталь на высоте отверстий и проверяет, что каждое отверстие — отдельный контур нужного диаметра; плюс измеряет минимальную стенку вокруг каждого отверстия лучами. |

Проверка после правки:

```
M4 fan  (±8,25/±79,75; ±35,75)  Ø5,5  min wall 2,35–4,25 мм   ok
M3 wall (±70; ±36,5)            Ø4,4  min wall 4,85 мм        ok
M3 clear в стенке (z=38)        Ø3,6                           ok
RESULT: OK — no merged holes, walls thick enough
```

Пересобраны `stl/01_base.stl`, `stl/02_wall_front.stl`, `stl/03_wall_rear.stl` и
проекты `01_base.3mf`, `02_wall_front.3mf`, `03_wall_rear.3mf`.
`04_roof` и `05_filter_tray` не менялись — их можно печатать из прежних файлов.

Масса цоколя 128,7 → 130,8 г, время 4 ч 05 м → 4 ч 10 м.

## v1.0 — 2026-11-04

Первый релиз: цоколь, две стенки, крышка, фильтр-лоток; параметрическая модель,
STL, отчёты печати, проекты OrcaSlicer.
