HTOWERok/psu_cooler_ficsit/(commit log)

2026-11-04 v1.0 — FICSIT PSU cooling tower
    Five printable parts (base, 2 honeycomb walls, roof, filter tray) for a
    165 x 82 x 35 mm laptop power brick, cooled by 2 x 80 mm fans. No supports,
    watertight meshes, parametric Python source, ABS presets and Bambu .3mf projects.
    License: CC BY-NC-SA 4.0. Fan art, not affiliated with Coffee Stain Studios.
    [01_base.3mf, 01_base.stl, 02_wall_front.3mf, 02_wall_front.stl, 03_wall_rear.3mf, 03_wall_rear.stl, 04_roof.3mf, 04_roof.stl]
2026-11-04 docs: адрес репозитория и порядок работы с git
2026-11-09 v1.2 — правки после первой печати
    - уши-башмаки вместо 4-мм полок, отверстия M3/M4 «каплей», перемычка сот 3,1 мм
    - жёлоб 7 x 4 мм под провода кулеров, сквозные пазы причала под стяжку
    - экспорт без зеркалирования: rotate вместо mirror для цоколя и крышки
    - профили ABS: PA 0,045, первый слой 0,72/0,35, top_surface_flow 0,95
    - фото первой печати в First_print/, разбор замечаний в docs/REWORK_v2.md
    - README: масса 359 г, новые объёмы и нависани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
    [01_base.3mf, 01_base.stl, 02_wall_front.3mf, 02_wall_front.stl, 03_wall_rear.3mf, 03_wall_rear.stl, 04_roof.3mf, 04_roof.stl]
2026-11-09 photos: готовое собранное изделие (v1.2) в README
2026-11-09 docs: текст публикации под Printables, массы и контакт слоя по v1.2
2026-11-09 docs: ссылка на модель в Printables
